malbu/cursed_furby/furby_daytime.JPG

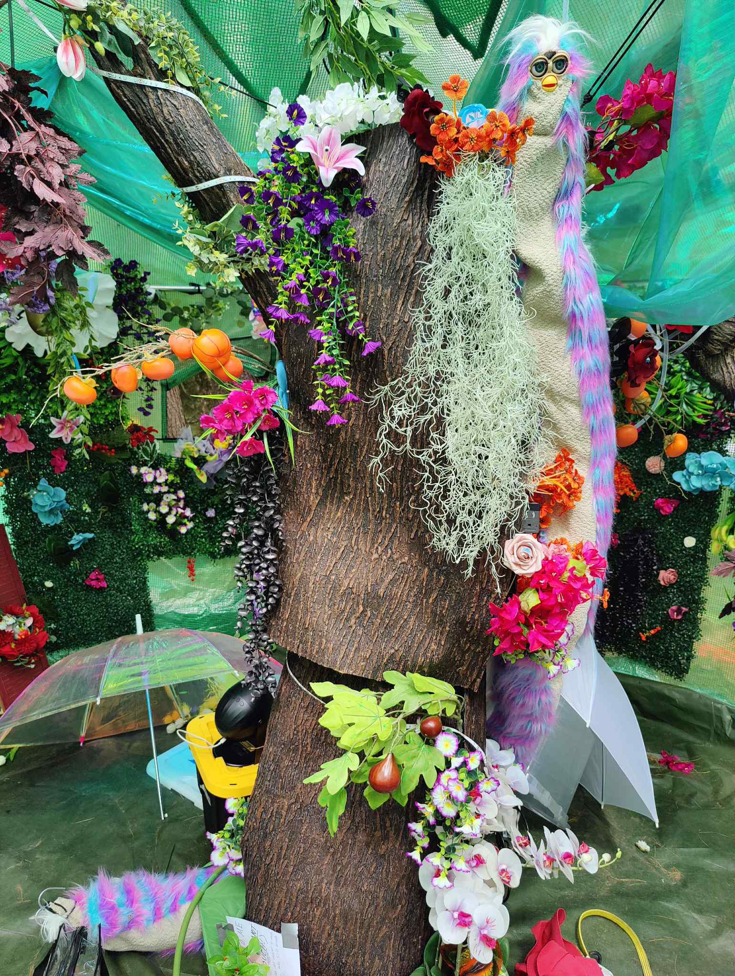
furby_daytime.JPG
