malbu/cursed_furby/hardware/cam_rotation.png

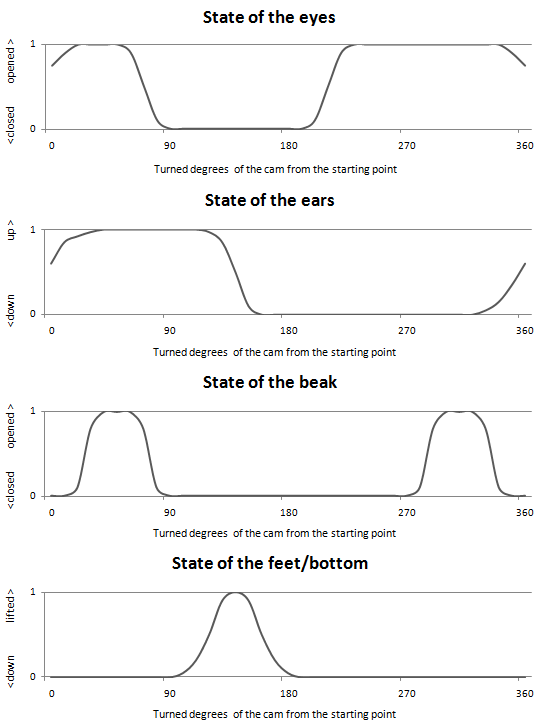
hardware/cam_rotation.png
