malbu/cursed_furby/(list of files, drawings)

Other design files:
hardware/cursed_furby_wiring.fzz
hardware/cursed_furby_wiring_2.fzz
