malbu/cursed_furby/hardware/cursed_furby_wiring_bb.png

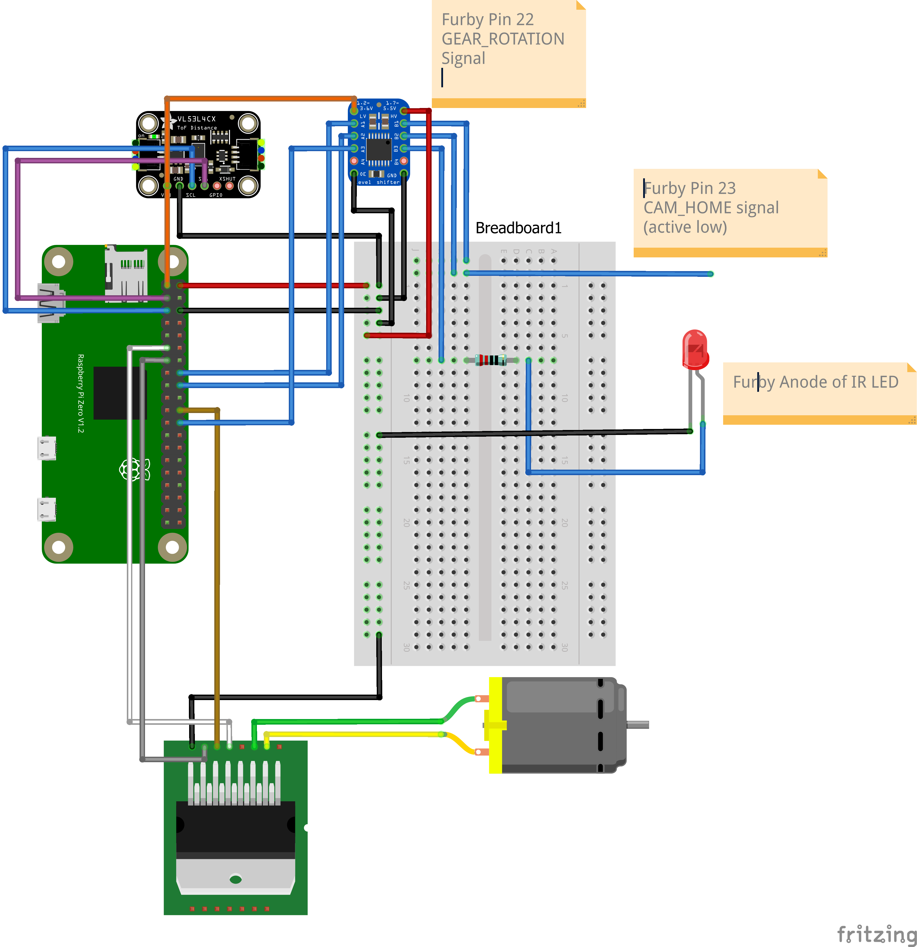
hardware/cursed_furby_wiring_bb.png
