malbu/cursed_furby/(commit log)

2025-05-21 testing tof and heart/breathing on raspberry pi zero w
2025-05-21 added pi to tof sensor pinout
    [wiring_pi_tof.csv]
2025-05-21 created fritzing wiring diagram; exported also as png
    [cursed_furby_wiring.fzz]
2025-06-08 removed distance measurements for now because it's still not working
    [heart_rate_without_spam.py]
2025-06-08 first motor test
2025-06-08 created script that also includes distance measurement, has a very simple moving average to smooth jitter and converts to seconds
    [hr_breathing_distance.py]
2025-06-13 updated cam sensor testing script to run motor
2025-06-13 created tester for vl53l1x sensor
2025-06-16 moved more stuff to hardware for cleanup
    [cursed_furby_wiring.fzz, cursed_furby_wiring_2.fzz]
2025-06-17 included prompt in triple quoted blocks
    [wiring_pi_tof.xlsx]
2025-06-22 start of mqtt integration; created motor and mr60bha2 test modules from test scripts; created mqtt client script
2025-06-24 added jetson helpers and fixed an import issue
    [mqtt_client.py]
2025-06-24 added config.py files to both broker and client side
    [__main__.py]
2025-06-24 promoted motor log output from debug to info
2025-06-24 created furby_egg_connected; based on furby_egg_cache_hardened.py but with mqtt connected vitals and motor control. Created the_furby.service to autostart.
    the_furby.service must be copied into ~/.config/systemd/user/
2025-06-25 Update sensor_mr60bha2.py
    if the sensor is not available due to crash or cable issue or whatever, it doesnt kill the whole pi mqtt service like before; it keeps trying to reconnect every 2 seconds but the motor control stays alive
    [sensor_mr60bha2.py]
2025-06-25 Update furby_egg_connected.py
    replace aplay pipeline simpleaudio playback so I can publish motor queues more precisely around playback. Previously aplay initialization was causing motor to start way before sound from response was heard
2025-06-27 for furby_queen_silence_gate; wrap gather() call inside coroutine. Also idle_watcher speaks only if build_tag returns non-empty string. When all vitals are skipped it reset the timer
2025-06-27 fixed two issues
    first idle timer started ticking before any human interaction; it now waits for the first successful user turn
    secondly idle ping audio was rerecorded and treated as user input. now during playback the recorder waits, and resumes after the speaker is silent
2025-06-29 updated config.yaml to test wireless router
2025-07-20 repo cleanup
    [wiring_pi_tof.csv, wiring_pi_tof.xlsx]
2025-09-06 switched README
